rissson/media_poe_splitter/media_poe_splitter.kicad_pcb

## KiCad design media_poe_splitter.kicad_pcb (2025-04-03)

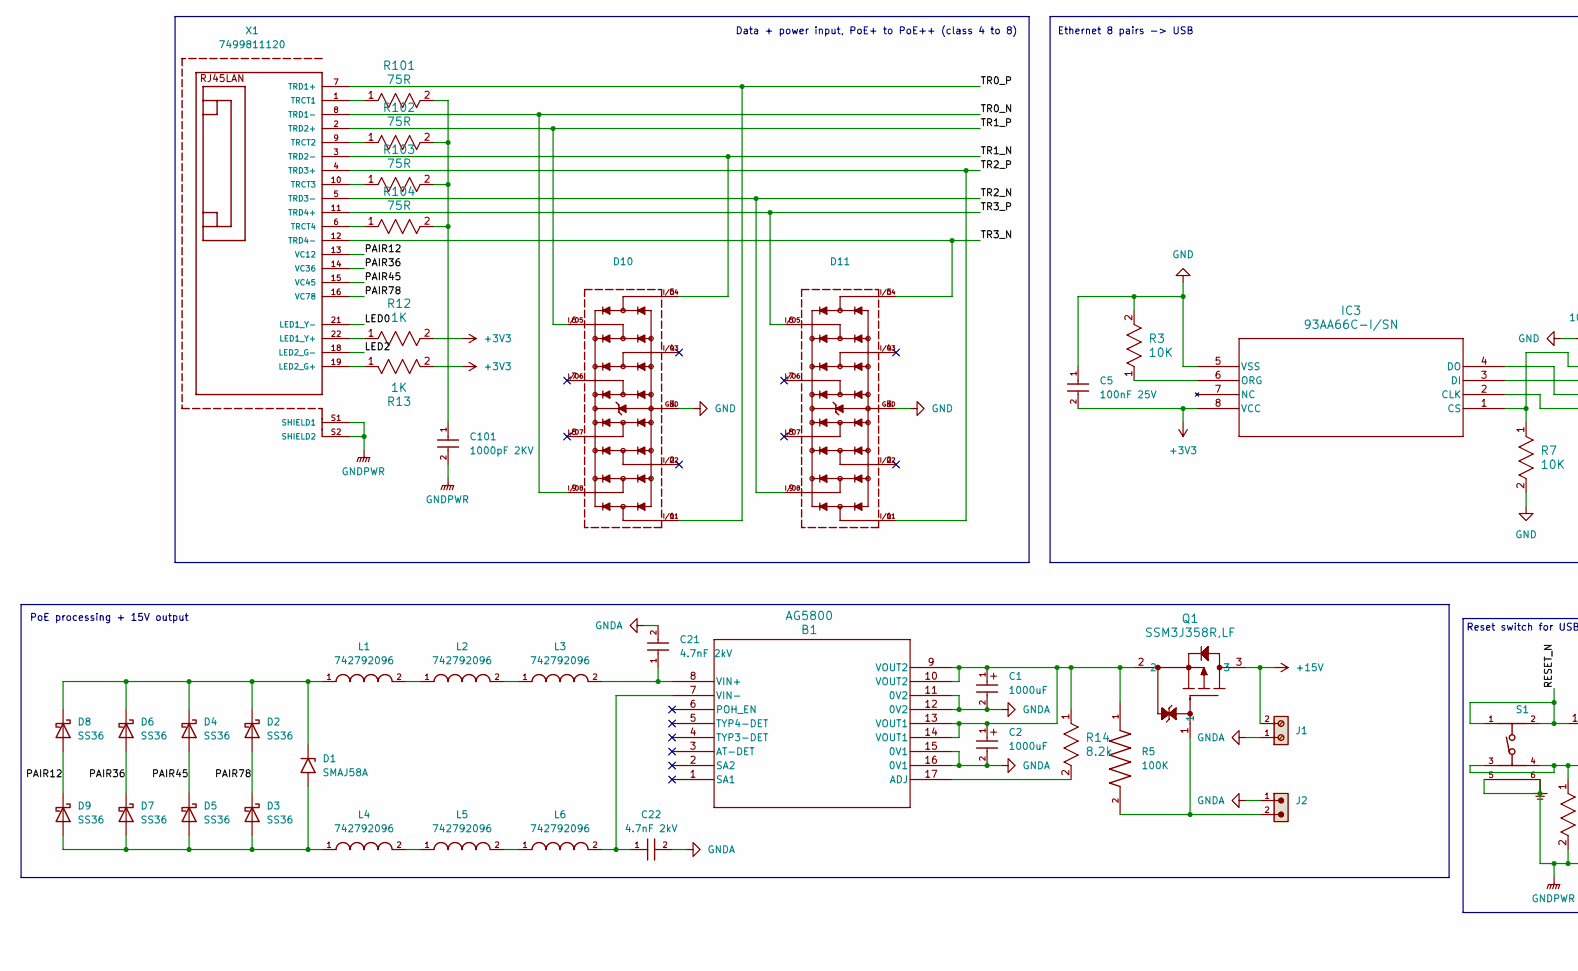
[picture p1: schematic media_poe_splitter.kicad_sch, PoE splitter to 24V + USB, part in row 1, column 1]

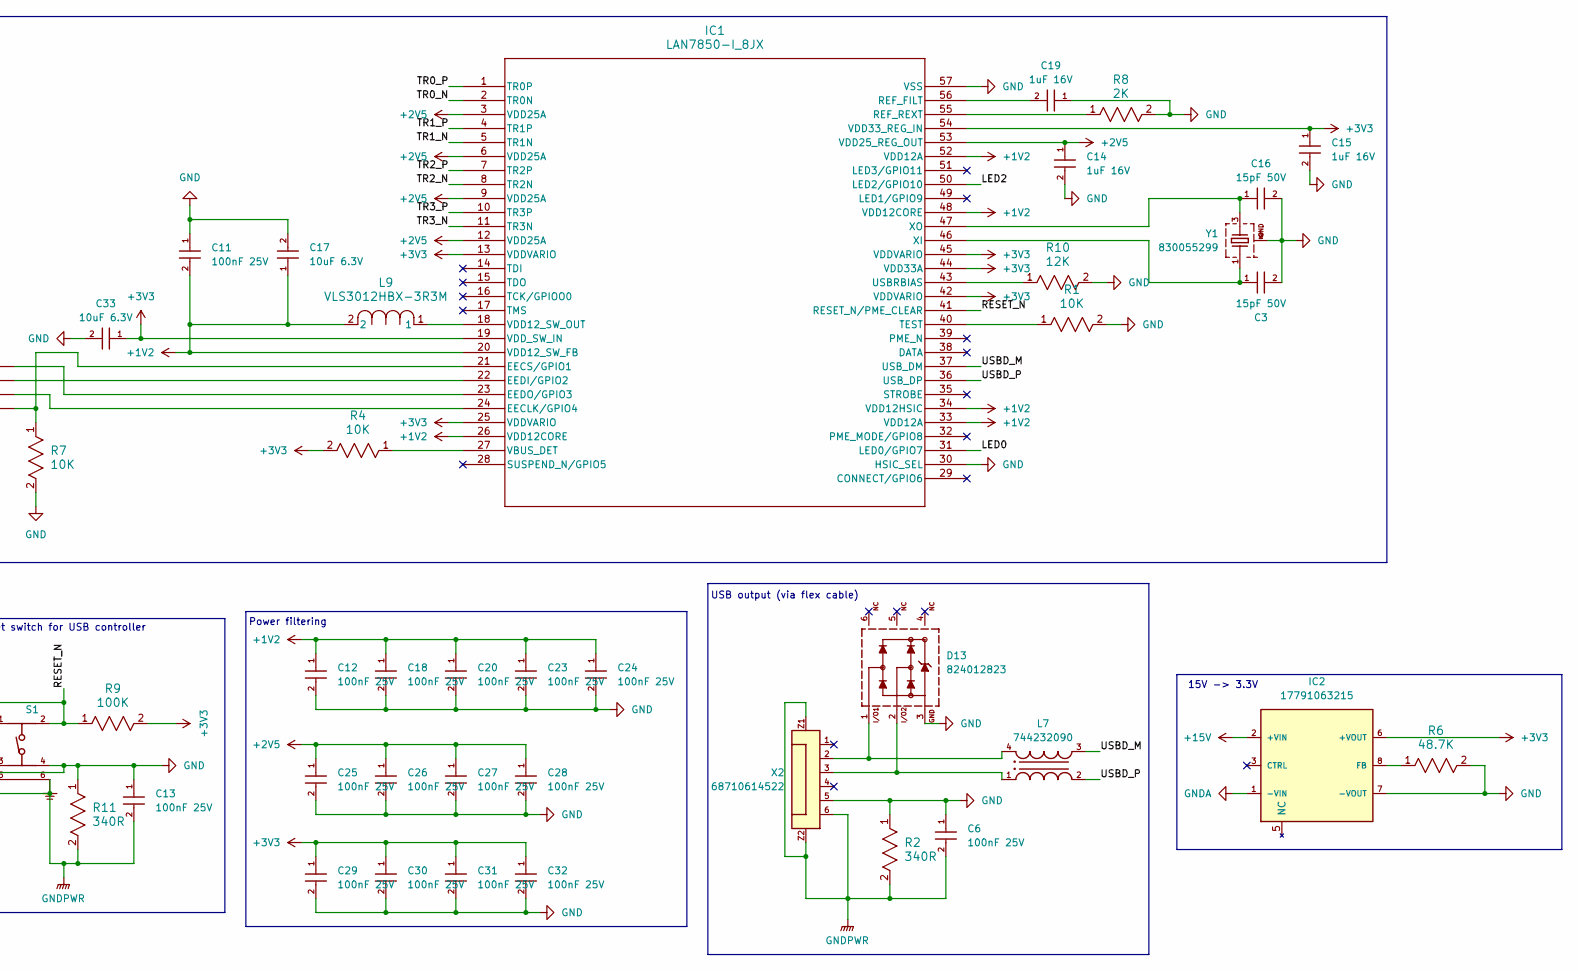
[picture p2: schematic media_poe_splitter.kicad_sch, PoE splitter to 24V + USB, part in row 1, column 2]

Parts:
B1: AG5800; MPN Ag5800
C1, C2: 1000uF; 860020578018; MPN 860020578018
C3, C16: 15pF 50V; 885012005056; MPN 885012005056
C5, C6, C11, C12, C13, C18, C20, C23, C24, C25, C26, C27, C28, C29, C30, C31, C32: 100nF 25V; 885012206071; MPN 885012206071
C14, C15, C19: 1uF 16V; 885012206052; MPN 885012206052
C17, C33: 10uF 6.3V; 885012207003; MPN 885012207003
C21, C22: 4.7nF 2kV; 885342208020; MPN 885342208020
C101: 1000pF 2KV; 885342208024; MPN 885342208024
D1: SMAJ58A; D_SMA; MPN SMAJ58A
D2, D3, D4, D5, D6, D7, D8, D9: SS36; D_SMA; MPN SS36
D10, D11: 5Vdc; 824014885; MPN 824014885
D13: 824012823; MPN 824012823
IC1: LAN7850-I_8JX; MPN LAN7850-I/8JX
IC2: 17791063215; MPN 17791063215
IC3: 93AA66C-I/SN; 93AA66C-I_SN; MPN 93AA66C-I/SN
J1: Screw_Terminal_01x02; 691210910002; MPN 691210910002
J2: 61300211121; PART-NUMBER 61300211121
L1, L2, L3, L4, L5, L6: 742792096; MPN 742792096
L7: 744232090; MPN 744232090
L9: VLS3012HBX-3R3M; MPN VLS3012HBX-3R3M
Q1: SSM3J358R,LF; MPN SSM3J358R,LF
R1, R3, R4, R7: 10K; RC0603FR-0710KL; MPN RC0603FR-0710KL
R2, R11: 340R; RC0603FR-07340RL; MPN RC0603FR-07340RL
R5: 100K; RC1206FR-07100KL; MPN RC1206FR-07100KL
R6: 48.7K; RC0603FR-0748K7L; MPN RC0603FR-0748K7L
R8: 2K; RC0603FR-072KL; MPN RC0603FR-072KL
R9: 100K; RC0603FR-07100KL; MPN RC0603FR-07100KL
R10: 12K; RC0603FR-0712KL; MPN RC0603FR-0712KL
R12, R13: 1K; RC1206FR-071KL; MPN RC1206FR-071KL
R14: 8.2k; RC0603FR-078K2L; MPN RC0603FR-078K2L
R101, R102, R103, R104: 75R; RC0805FR-0775RL; MPN RC0805FR-0775RL
S1: 435151014824; MPN 435151014824
X1: 7499811120; MPN 7499811120
X2: 68710614522; MPN 68710614522
Y1: 830055299; MPN 830055299

Connections:
+1V2: C11.2, C12.1, C17.1, C18.1, C20.1, C23.1, C24.1, IC1.20 (VDD12_SW_FB), IC1.26 (VDD12CORE), IC1.33 (VDD12A), IC1.34 (VDD12HSIC), IC1.48 (VDD12CORE), IC1.52 (VDD12A), L9.2
+2V5: C14.1, C25.1, C26.1, C27.1, C28.1, IC1.3 (VDD25A), IC1.6 (VDD25A), IC1.9 (VDD25A), IC1.12 (VDD25A), IC1.53 (VDD25_REG_OUT)
+3V3: C5.2, C15.1, C29.1, C30.1, C31.1, C32.1, C33.1, IC1.13 (VDDVARIO), IC1.19 (VDD_SW_IN), IC1.25 (VDDVARIO), IC1.42 (VDDVARIO), IC1.44 (VDD33A), IC1.45 (VDDVARIO), IC1.54 (VDD33_REG_IN), IC2.6 (+VOUT), IC3.8 (VCC), R4.2, R9.2, R12.2, R13.2
+15V: IC2.2 (+VIN), J1.2, Q1.3
/LED0: IC1.31 (LED0/GPIO7), X1.21 (LED1_Y-)
/LED2: IC1.50 (LED2/GPIO10), X1.18 (LED2_G-)
/PAIR12: D8.2 (A), D9.1 (K), X1.13 (VC12)
/PAIR36: D6.2 (A), D7.1 (K), X1.14 (VC36)
/PAIR45: D4.2 (A), D5.1 (K), X1.15 (VC45)
/PAIR78: D2.2 (A), D3.1 (K), X1.16 (VC78)
/RESET_N: IC1.41 (RESET_N/PME_CLEAR), R9.1, S1.1, S1.2
/TR0_N: D10.9, IC1.2 (TR0N), X1.8 (TRD1-)
/TR0_P: D10.1, IC1.1 (TR0P), X1.7 (TRD1+)
/TR1_N: D10.5, IC1.5 (TR1N), X1.3 (TRD2-)
/TR1_P: D10.6, IC1.4 (TR1P), X1.2 (TRD2+)
/TR2_N: D11.9, IC1.8 (TR2N), X1.5 (TRD3-)
/TR2_P: D11.1, IC1.7 (TR2P), X1.4 (TRD3+)
/TR3_N: D11.5, IC1.11 (TR3N), X1.12 (TRD4-)
/TR3_P: D11.6, IC1.10 (TR3P), X1.11 (TRD4+)
/USBD_M: IC1.37 (USB_DM), L7.3
/USBD_P: IC1.36 (USB_DP), L7.2
GND: C3.2, C5.1, C6.1, C11.1, C12.2, C13.1, C14.2, C15.2, C16.2, C17.2, C18.2, C19.1, C20.2, C23.2, C24.2, C25.2, C26.2, C27.2, C28.2, C29.2, C30.2, C31.2, C32.2, C33.2, D10.3, D11.3, D13.3, IC1.30 (HSIC_SEL), IC1.57 (VSS), IC2.7 (-VOUT), IC3.5 (VSS), R1.2, R2.1, R3.2, R6.2, R7.2, R8.2, R10.2, R11.1, S1.3, S1.4, X2.5, Y1.2, Y1.4
GNDA: B1.11 (0V2), B1.12 (0V2), B1.15 (0V1), B1.16 (0V1), C1.2, C2.2, C21.2, C22.2, IC2.1 (-VIN), J1.1, J2.1
GNDPWR: C6.2, C13.2, C101.2, R2.2, R11.2, S1.5, S1.6, X1.S1 (SHIELD1), X1.S2 (SHIELD2), X2.6, X2.Z1, X2.Z2
unnamed: B1.17 (ADJ), R14.2
unnamed: B1.8 (VIN+), C21.1, L3.2
unnamed: B1.7 (VIN-), C22.1, L6.2
unnamed: B1.9 (VOUT2), B1.10 (VOUT2), B1.13 (VOUT1), B1.14 (VOUT1), C1.1, C2.1, Q1.2, R5.1, R14.1
unnamed: C101.1, R101.2, R102.2, R103.2, R104.2
unnamed: D1.1 (A1), D2.1 (K), D4.1 (K), D6.1 (K), D8.1 (K), L1.1
unnamed: D1.2 (A2), D3.2 (A), D5.2 (A), D7.2 (A), D9.2 (A), L4.1
unnamed: D13.1, L7.4, X2.2
unnamed: D13.2, L7.1, X2.3
unnamed: IC1.24 (EECLK/GPIO4), IC3.2 (CLK)
unnamed: IC1.21 (EECS/GPIO1), IC3.1 (CS), R7.1
unnamed: IC1.22 (EEDI/GPIO2), IC3.3 (DI)
unnamed: IC1.23 (EEDO/GPIO3), IC3.4 (DO)
unnamed: C19.2, IC1.56 (REF_FILT)
unnamed: IC1.55 (REF_REXT), R8.1
unnamed: IC1.40 (TEST), R1.1
unnamed: IC1.43 (USBRBIAS), R10.1
unnamed: IC1.27 (VBUS_DET), R4.1
unnamed: IC1.18 (VDD12_SW_OUT), L9.1
unnamed: C3.1, IC1.46 (XI), Y1.1
unnamed: C16.1, IC1.47 (XO), Y1.3
unnamed: IC2.8 (FB), R6.1
unnamed: IC3.6 (ORG), R3.1
unnamed: J2.2, Q1.1, R5.2
unnamed: L1.2, L2.1
unnamed: L2.2, L3.1
unnamed: L4.2, L5.1
unnamed: L5.2, L6.1
unnamed: R12.1, X1.22 (LED1_Y+)
unnamed: R13.1, X1.19 (LED2_G+)
unnamed: R101.1, X1.1 (TRCT1)
unnamed: R102.1, X1.9 (TRCT2)
unnamed: R103.1, X1.10 (TRCT3)
unnamed: R104.1, X1.6 (TRCT4)

Notes on the sheet:
Reset switch for USB controller
Data + power input, PoE+ to PoE++ (class 4 to 8)
USB output (via flex cable)
15V -> 3.3V
Power filtering
Ethernet 8 pairs -> USB
PoE processing + 15V output

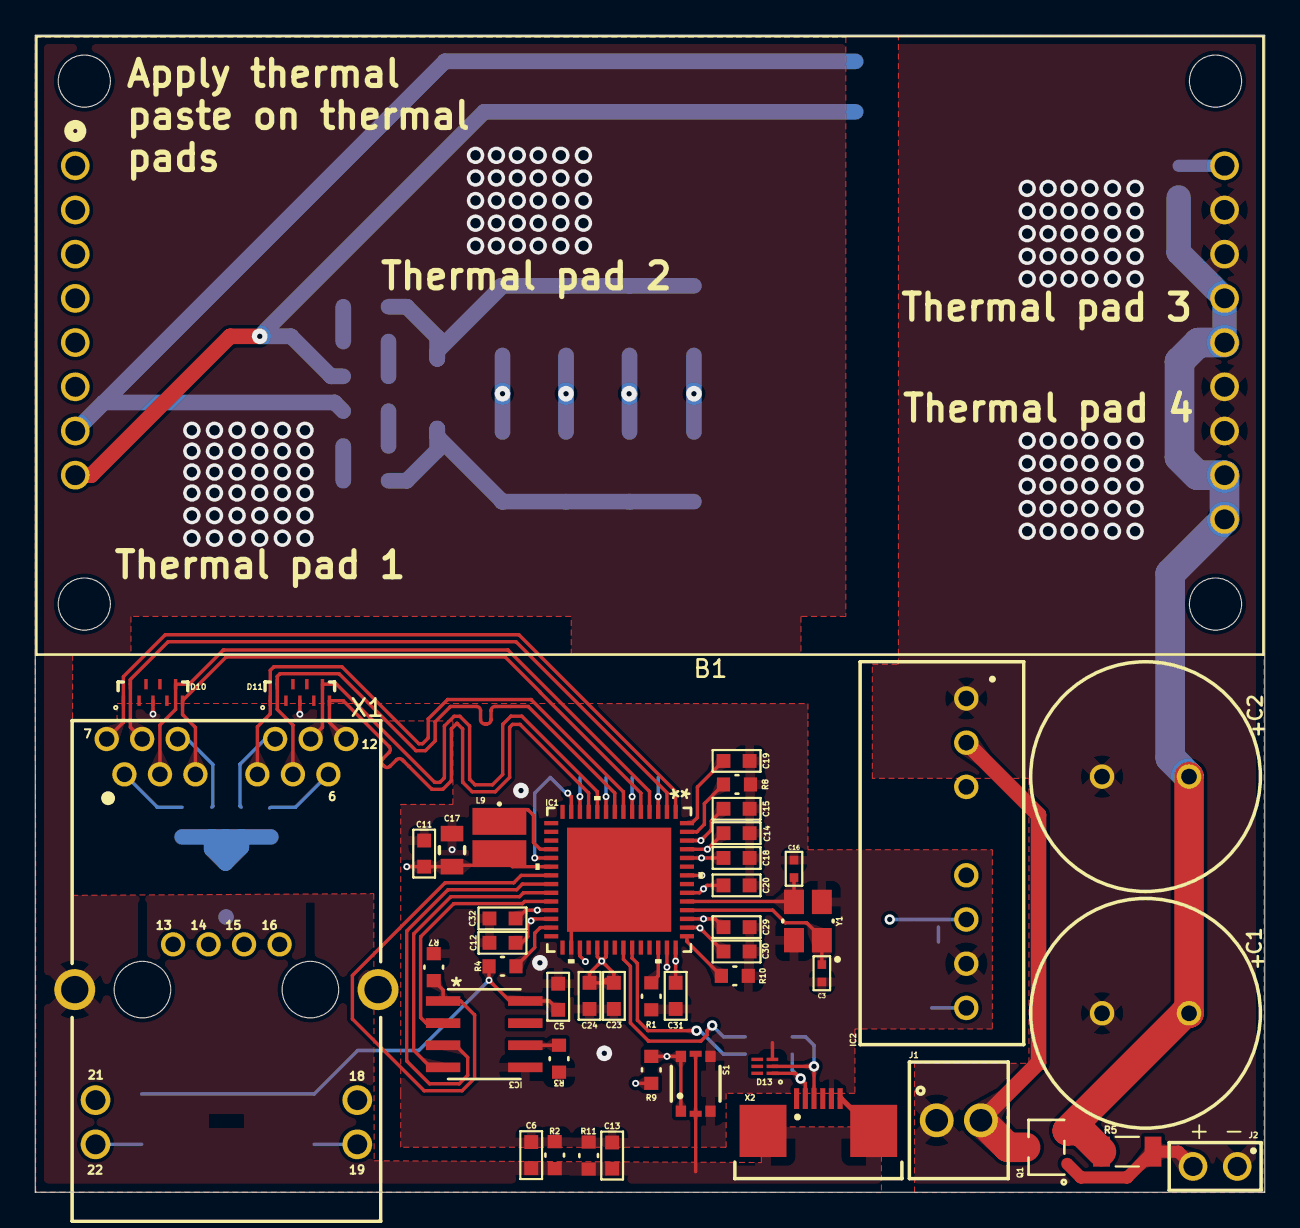
[picture p3: board media_poe_splitter.kicad_pcb from above]

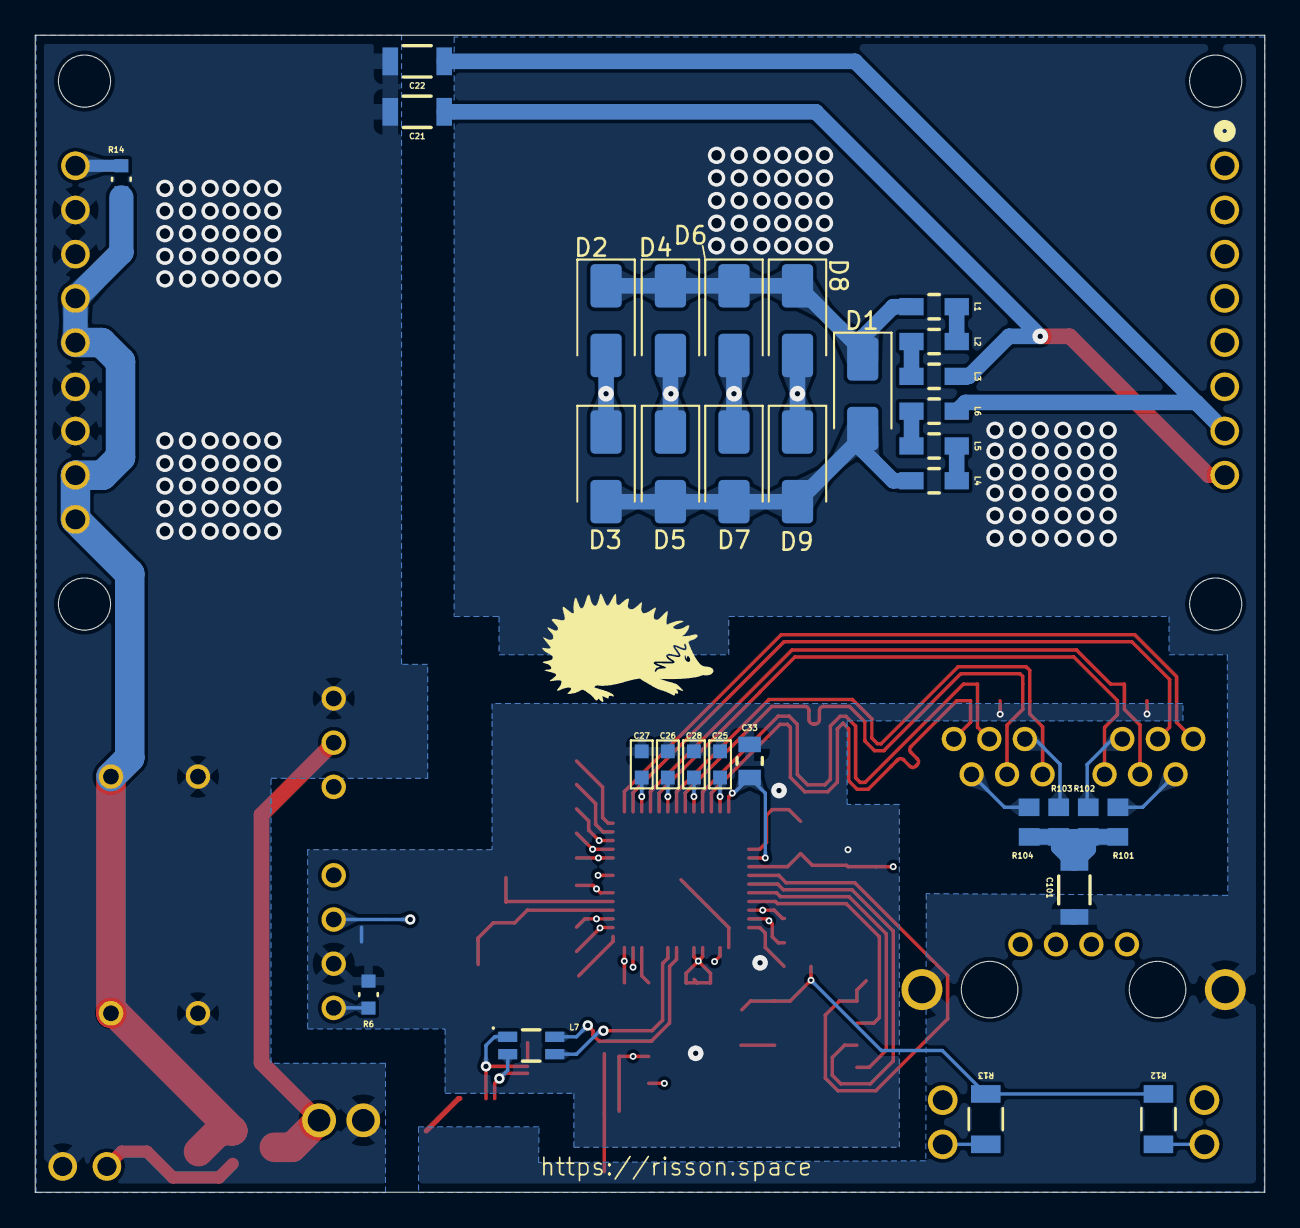
[picture p4: board media_poe_splitter.kicad_pcb from below]

Board: 4 copper layers, 70.7 x 66.5 mm, 78 parts (32 on the bottom side), 58 nets.
