rissson/media_poe_splitter/(commit log)

2025-01-22 Initial commit: PoE schematic and start of layout
    [media_poe_splitter.kicad_pcb, media_poe_splitter.kicad_sch]
2025-01-22 poe: add missing tracks
    [media_poe_splitter.kicad_pcb, media_poe_splitter.kicad_sch]
2025-01-25 add USB controller, finish board
    [media_poe_splitter.kicad_pcb, media_poe_splitter.kicad_sch, usb_breakout.kicad_pcb, usb_breakout.kicad_sch]
2025-01-26 replace NLA part
    [media_poe_splitter.kicad_pcb, media_poe_splitter.kicad_sch]
2025-01-26 schematic: cleanup
    [media_poe_splitter.kicad_sch]
2025-01-26 board: try to make sure that ethernet tracks have the same length
    [media_poe_splitter.kicad_pcb]
2025-01-26 usb breakout: avoid vias in pad
    [usb_breakout.kicad_pcb]
2025-01-26 poe splitter: transform output to be in series to allow switching it off
    [media_poe_splitter.kicad_pcb, media_poe_splitter.kicad_sch]
2025-01-28 tweak traces a bit
    [media_poe_splitter.kicad_pcb]
2025-01-29 Add MOSFET to 24V output for enable/disable capability
    [media_poe_splitter.kicad_pcb, media_poe_splitter.kicad_sch]
2025-01-29 board: tweak track sizes and fill zones
    [media_poe_splitter.kicad_pcb]
2025-01-29 board: more zone tweaks, give clearance to ethernet pairs
    [media_poe_splitter.kicad_pcb]
2025-01-30 Add LEDs for Ethernet monitoring
    [media_poe_splitter.kicad_pcb, media_poe_splitter.kicad_sch]
2025-01-30 Remove useless via
    [media_poe_splitter.kicad_pcb]
2025-01-30 board, schematic: try to comply with ERC and DRC
    [media_poe_splitter.kicad_pcb, media_poe_splitter.kicad_sch]
2025-02-09 Update vias, add logos
    [media_poe_splitter.kicad_pcb]
2025-03-30 Update KiCad to 9.0
    [media_poe_splitter.kicad_pcb, media_poe_splitter.kicad_sch]
2025-04-03 Fix voltage issues, bigger traces where needed
    [media_poe_splitter.kicad_pcb, media_poe_splitter.kicad_sch]
